KriegersBlog/color_sorting_machine/Dokumentation/Bilder zur Dokumentation/Fotos des Geräts/ansicht_oben.jpg

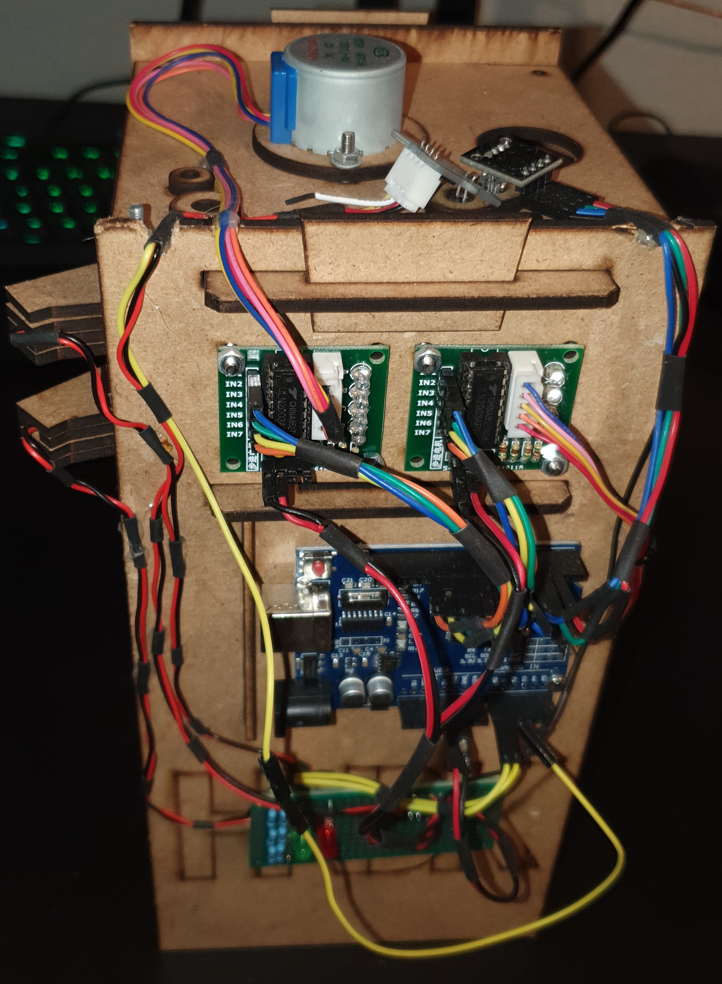
Dokumentation/Bilder zur Dokumentation/Fotos des Geräts/ansicht_oben.jpg
