KriegersBlog/color_sorting_machine/Dokumentation/Bilder zur Dokumentation/Programmablauf/PAP-farbeErkennen.png

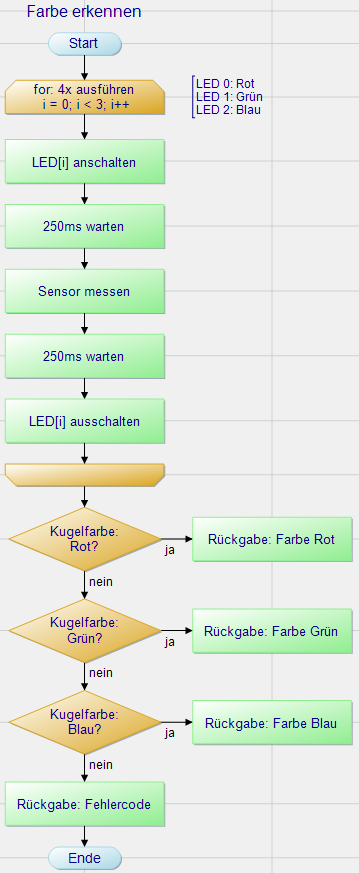
Dokumentation/Bilder zur Dokumentation/Programmablauf/PAP-farbeErkennen.png
