KriegersBlog/color_sorting_machine/Dokumentation/Bilder zur Dokumentation/Programmablauf/PAP-main.png

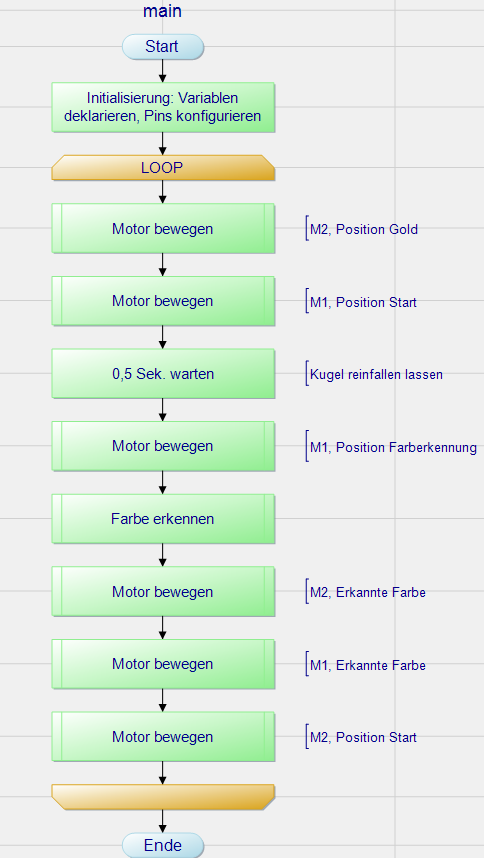
Dokumentation/Bilder zur Dokumentation/Programmablauf/PAP-main.png
