KriegersBlog/color_sorting_machine/Dokumentation/Bilder zur Dokumentation/Programmablauf/PAP-motorBewegen.png

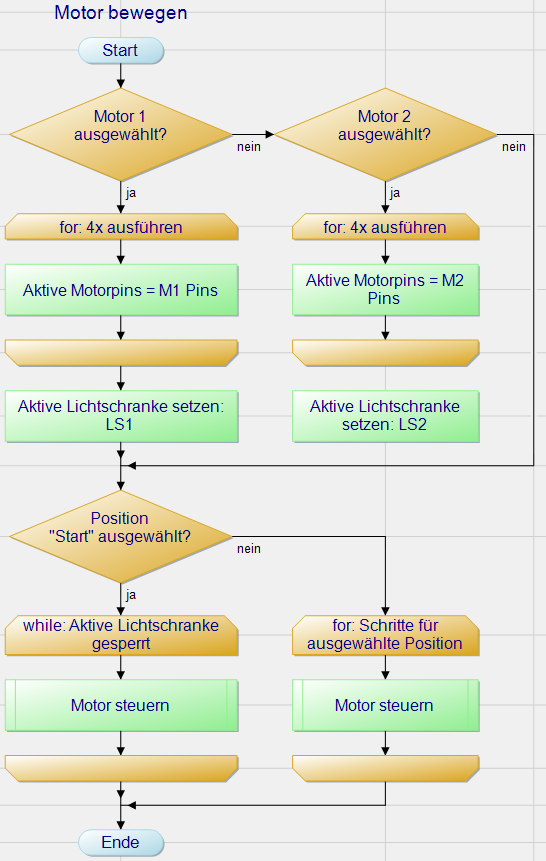
Dokumentation/Bilder zur Dokumentation/Programmablauf/PAP-motorBewegen.png
