KriegersBlog/color_sorting_machine/Dokumentation/Bilder zur Dokumentation/Programmablauf/PAP-motorSteuern.png

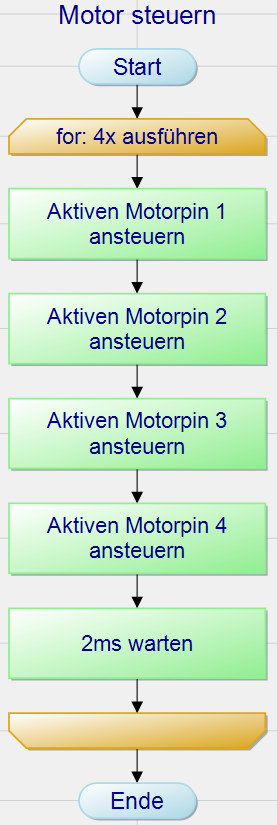
Dokumentation/Bilder zur Dokumentation/Programmablauf/PAP-motorSteuern.png
