KriegersBlog/color_sorting_machine/Dokumentation/Bilder zur Dokumentation/Schaltung/Steckplatine.png

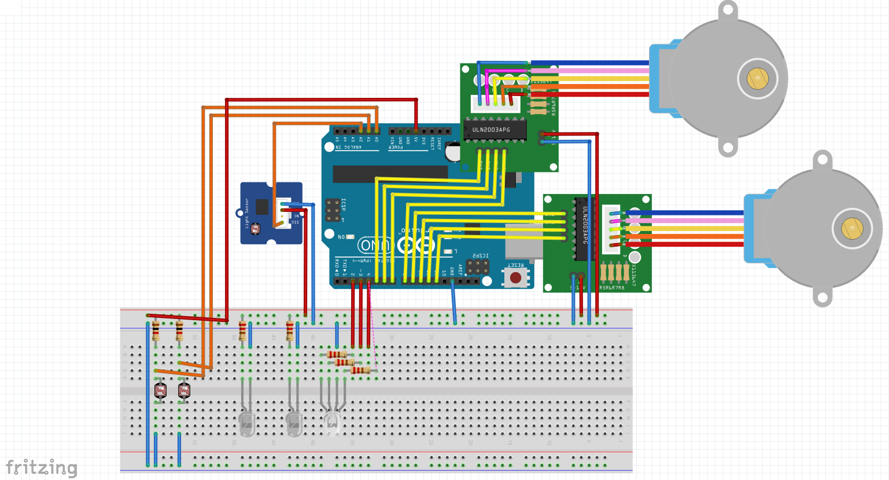
Dokumentation/Bilder zur Dokumentation/Schaltung/Steckplatine.png
