KriegersBlog/color_sorting_machine/Dokumentation/Bilder zur Dokumentation/Zeitplanung/Gantt-Ist.png

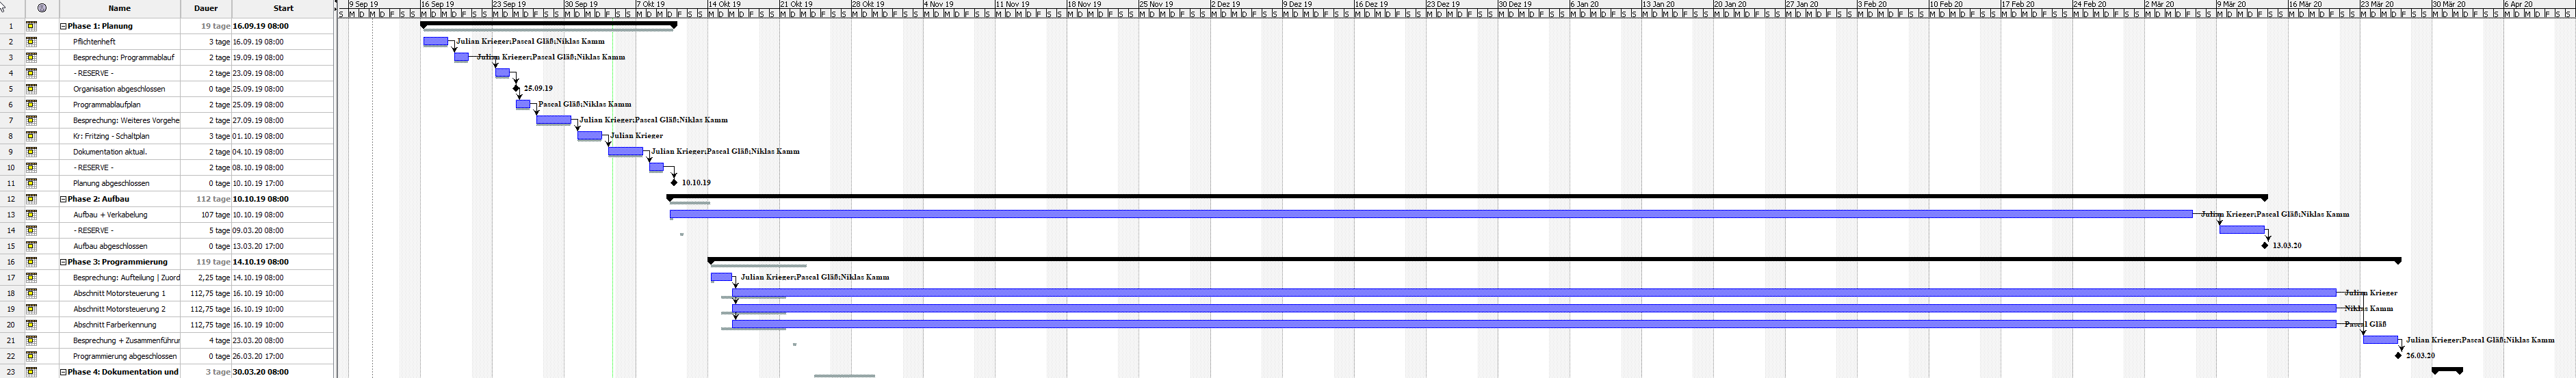
Dokumentation/Bilder zur Dokumentation/Zeitplanung/Gantt-Ist.png
