KriegersBlog/color_sorting_machine/(list of files, drawings)

Other design files:
Dokumentation/Schaltplan.fzz
